redfescue/Pepper/Pepper-photo.jpg

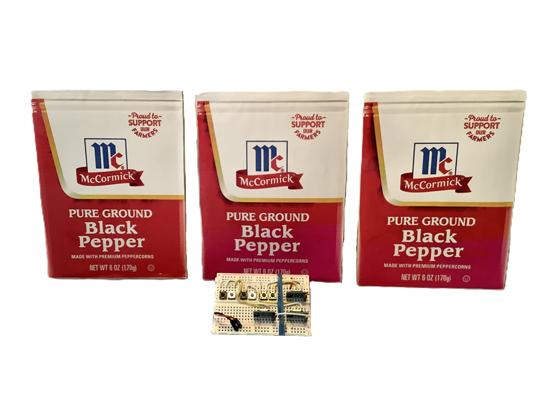
Pepper-photo.jpg
