redfescue/Pepper/pepper MP3 scripts_B.md

 

**Pepper audio scripts**			12/30/25

**Becky**

*Clip#   Script                        			duration*

20	Is that those damn birds again??  	2.7 sec

21	Do we have to hear about his stupid dog dream again??  4 sec

22	Did somebody let the Chordettes out?  2.6 sec

24	Not me, but here’s a weird dog  2.7 sec

27	The life you lead can be your own. 3.2 sec

012     You think that’s funny? It’s not!  2.5 sec

**Steve**

005   Did you say something, I thought I heard something?    5.9 sec

041   I’m sorry, you can’t stand here – this is where the dogs come ashore

**Other clips**

30	Barking dog   8.5 sec

29	Cat meows   5.8 sec

01      bird  4 sec

16	bird  4 sec

02	bird  4 sec

15	bird  4 sec

**Steve**

19   That’s Pepper by the Butthole Surfers  3.6

31    You eat it!  1.5

32   That devil is a birdbrain \& I’m a pepper box.  8.0

33   You need to hear about the Dog Dream!

35   She got peppered with questions.   2.4

36   The alien is impersonating the Chordettes  3.6

37   Butthole, butthole!   1.6

38   Made with Premium Peppercorns.   3.1

89 	Yes, we do have to hear about the dog dream. Steve dreamed that he was standing on a concrete covered lot beside a river and next to a post office. A woman comes and stands near to Steve, but closer to the river. Steve tells her “ I’m sorry ma’m, you can’t stand here, this is where the dogs come ashore”. The dogs have pouches on their backs which contain the mail. They’re taking it to the post office.  The dogs are swimming across the river to take the mail to the post office! 38 sec

**Becky**

34   Don’t forget to pepper your remarks with witticisms  5.0

40   You said butthole!!   1.6

45    No, you eat it!   1.1

46   Here’s Black Pepper by the Yoruba Singers   3.6

47   Here’s Black Pepper by Micropop  2.8

48   She gave salty answers   2.6

49   Pepper box, black pepper box  2.6

50   Here is Stone Love by Pepper   3.0

**Songs**

These songs are not in the MP3 folder. You will need to supply your own audio clips for these. Alternatively, you could use some of the included clips by changing the number and delay in the programs. I bought most of these on Itunes, copied them as MP3 with Itunes and imported them into Audacity. From Audacity, I copied them into the SD card

82   Lay Down Your Arms – Chordettes - I downloaded this from "Chordettes Greatest Hits" 24 seconds only

84   Never on Sunday - Chordettes  - I downloaded this from "Chordettes Greatest Hits" 42 seconds ony

85   Ghost riders in the sky – Highwaymen  3:15

86   Beverly Hills - Weezer 3:15

87   Black Pepper by Yoruba Singers  3:00 appx

88   Black Pepper by Micropop   31 sec

90   What’s up by 4 non-Blondes 4:10

91   Stone Love by Pepper 1:50

92   Rough Boy by ZZ Top 3:50

100   Pepper by the Butthole Surfers 1:42
